kwasek404/Akwarium/app/sterownik_oswietlenia/src/Constants.h

#ifndef CONSTANTS_H
#define CONSTANTS_H

#include <Arduino.h>

// Pin Definitions
const uint8_t BUTTON_RIGHT_PIN = 12;
const uint8_t BUTTON_SET_PIN = 11;
const uint8_t BUTTON_MINUS_PIN = 10;
const uint8_t BUTTON_PLUS_PIN = 9;

const uint8_t RTC_CLK_PIN = 6;
const uint8_t RTC_DAT_PIN = 7;
const uint8_t RTC_RST_PIN = 8;

const uint8_t VOLTAGE_FEEDBACK_PIN = A2;
const uint8_t VOLTAGE_OUTPUT_PIN = 5;

const uint8_t SWITCH_TRANSFORMER_PIN = 2;
const uint8_t SWITCH_BALLAST_1_PIN = 3;
const uint8_t SWITCH_BALLAST_2_PIN = 4;
const uint8_t SWITCH_BALLAST_3_PIN = A3;

// I2C LCD Configuration
const uint8_t LCD_ADDRESS = 0x27;
const uint8_t LCD_COLS = 16;
const uint8_t LCD_ROWS = 2;

// EEPROM Addresses
const int EEPROM_TIMER_START_HOUR_ADDR = 0;
const int EEPROM_TIMER_START_MINUTE_ADDR = 1;
const int EEPROM_TIMER_STOP_HOUR_ADDR = 2;
const int EEPROM_TIMER_STOP_MINUTE_ADDR = 3;
const int EEPROM_TIMEZONE_ADDR = 4;

// Behavior Constants
const unsigned long ACTIVITY_BACKLIGHT_SECONDS = 60;
const unsigned long BUTTON_DEBOUNCE_DELAY = 50; // ms
const unsigned long LONG_PRESS_DELAY = 500; // ms to trigger a long press
const unsigned long HOLD_REPEAT_DELAY = 150; // ms between repeats when holding
const unsigned long SEQUENTIAL_SWITCH_DELAY_MS = 1000; // 1 second between switching ballasts
const unsigned long RTC_SYNC_INTERVAL_MS = 60000UL; // 60s between RTC hardware reads
const unsigned long STABILITY_WINDOW_MS = 10000UL;   // continuous window in ±2% before relay switch
const unsigned long SOFT_START_DURATION_MS = 120000UL; // 2 min ramp on boot/time-jump into active period
const unsigned long FAN_COOLDOWN_MS = 300000UL; // 5 minutes cooldown after lights off
const unsigned long TRANSFORMER_WARMUP_MS = 1500; // 1.5s for 1-10V circuit stabilization

// Lighting Control
const int ANALOG_READ_RESOLUTION = 1023;
const int ANALOG_WRITE_RESOLUTION = 255;

// Voltage regulation - proportional controller with clamped step
// Large errors -> fast corrections; small errors -> fine tuning.
// At ~200Hz: MAX_VOLTAGE_STEP*200 = 20%/s max; near target (<10% error): proportional, quieter.
const float VOLTAGE_KP       = 0.01f;  // proportional gain (error% -> step%)
const float MAX_VOLTAGE_STEP = 0.1f;   // max step per call (% of control range)
const float MIN_COLD_PER_TUBE_POWER = 50.0f;   // cold-start minimum per-tube % (arc ignition)
const float MIN_WARM_PER_TUBE_POWER = 5.0f;    // warm operation minimum per-tube % (stable arc)
const unsigned long TUBE_WARMUP_MS = 300000UL;  // 5 min for tube arc/gas stabilization

// QTi Osram T5HO 54W power model (per ballast)
// System watts = overhead + tubes * (CATHODE_WATTS + ARC_WATTS_PER_TUBE * dimFraction)
// Verified: B1/B2 @100% = 12 + 2*(3.5+50.5) = 120W, B3 @100% = 8 + 1*54 = 62W
const float BALLAST_PAIR_OVERHEAD_WATTS = 12.0f;  // B1/B2 static electronics draw
const float BALLAST_SINGLE_OVERHEAD_WATTS = 8.0f; // B3 static electronics draw
const float CATHODE_WATTS_PER_TUBE = 3.5f;         // cathode heating, constant when lit
const float ARC_WATTS_PER_TUBE = 50.5f;            // scales linearly with dimming

// UI Constants
const int MAIN_MENU_SIZE = 5;

#endif // CONSTANTS_H
