kwasek404/Akwarium/(commit log)

2021-07-03 #3 fix problemów z timestamp
    [main.ino]
2021-07-04 #3 screen timera + zapis odczyt eeprom
2021-07-04 #3 fix wyświetlania czasu
    [main.ino]
2021-07-06 #3 korekta obliczania voltów na podstawie procentów
2025-10-05 feat: Add initial project structure and core components
    This commit introduces the foundational elements for the aquarium lighting controller project.
    - **New files:**
    - `Constants.h`: Defines global constants.
    - `DisplayController.h`: Manages the display interface.
    - `InputManager.h`: Handles user input.
    - `LightingController.h`: Controls the lighting system.
    - `Settings.h`: Stores and manages device settings.
    - `TimeController.h`: Manages time-related functionalities.
    - `UIManager.h`: Manages the user interface.
    - **Modified files:**
    - `platformio.ini`: Updated project configuration.
    - `main.ino`: Initialized main application logic.
2025-12-30 Revert: shutdown order. Fix: time instability. Preserve PWM 0 on OFF.
    [LightingController.h]
2025-12-30 Feat: Implement permanent transformer ON workaround for shutdown stability
    Implements the user-requested workaround to permanently keep the 1-10V transformer enabled. The shutdown sequence now only turns off ballasts and performs a soft PWM ramp-down, leaving the transformer active to prevent system crashes.
    - Refactored LightingController state machine (STOPPING_BALLASTS, RAMPING_DOWN).
    - Introduced managePwmRampAndCheck for 10s PWM ramp to discharge the circuit with feedback validation.
    - Removed all digitalWrite(SWITCH_TRANSFORMER_PIN, HIGH); calls from shutdown paths.
    - Optimized memory usage by disabling debug messages (DEBUG_ENABLED commented out in Debug.h) to ensure stable operation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
    [Debug.h, LightingController.h]
2025-12-31 feat: Implement final 'Prestige Plus' architecture
    - Refactor LightingController with lumen compensation and fault detection.
    - Refactor UIManager with 'wake screen' and live-edit UI fixes.
    - Refactor Schedule.h with Total System Power definition.
    - NOTE: This commit captures the complete, final logic.
    [LightingController.cpp, LightingController.h, Schedule.h, UIManager.h]
2025-12-31 feat: Finalize "Super Controller" with advanced lighting logic and UI
    This commit encapsulates the entire development process of the Aquarium Controller firmware, evolving from initial bug fixes to a sophisticated, feature-rich "Prestige Plus" lighting management system.
    Key features and fixes implemented:
    - Initial stability fix: Addressed controller freezing at 0% power by ensuring safe PWM state before transformer shutdown.
    - Memory optimization: Resolved time instability issues by removing an unused large buffer in , significantly reducing RAM usage.
    - Advanced Scheduler: Implemented a dynamic, proportional multi-phase lighting schedule with Siesta, scaling automatically to user-define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
    [LightingController.cpp, LightingController.h, Schedule.h, UIManager.h]
2025-12-31 feat: Finalize "Super Controller" with advanced logic and UI
    This commit delivers the complete, feature-rich "Prestige Plus" Aquarium Controller firmware.
    It includes advanced scheduling, lumen-compensated ballast switching, fault detection, robust startup, and fault-tolerant timekeeping.
    All UI/UX enhancements and comprehensive documentation in README.md are finalized.
2025-12-31 Fix: Refresh display even when backlight is off
    [UIManager.h]
2026-04-03 feat: RTC reliability hardening and 12V relay EMI protection
    Multi-layer defense against DS1302 time loss from transformer PSU
    transients: quorum boot voting (7 reads, 3+ must agree), BCD
    validation on every read, WP=1 as default state, no automatic
    writes in main loop. 12V relay switching EMI mitigation via RTC
    read suppression (500ms) and LCD reinitialization. Documentation
    for hardware fix (3.3V + Schottky diode + 220uF capacitor).
    [Constants.h, DisplayController.h, LightingController.cpp, LightingController.h, TimeController.h, UIManager.h, main.ino]
2026-04-06 docs: update RTC reliability with signal line filtering and fallback plan
2026-04-06 fix: fault timer reset, simplify power math, correct Dusk startPower, remove dead RAMP_DOWN state
    [LightingController.cpp, LightingController.h, Schedule.h]
2026-04-06 feat: dynamic ballast selection with daily B1/B2 rotation for tube longevity
2026-04-14 fix: add WDT watchdog and EMI protection for ballast relay switching
    [LightingController.cpp, main.ino]
2026-04-15 refactor: periodic RTC sync with millis() interpolation, stability counter for ballast transitions
    [Constants.h, LightingController.cpp, LightingController.h, TimeController.h, main.ino]
2026-04-16 feat: deferred clock edit and 2-min soft-start on power-cycle or time change
2026-04-24 fix: proportional regulator with 10s stability window, schedule tweaks, override backend
    [Constants.h, LightingController.cpp, LightingController.h, Schedule.h]
2026-04-24 feat: add manual Override screen with on/off and 0-100% power in 10% steps
2026-04-28 feat: hybrid cold/warm tube power thresholds to eliminate buzzing
    [Constants.h, LightingController.cpp, LightingController.h, Schedule.h]
2026-04-29 fix: override works when lights off, staged edit with SET confirmation
    [LightingController.cpp, UIManager.h]
